ehughes/FPGA_SHIELD_MARK1/SCH/MARK1/REV A/Mechanical_Notes.txt

**** Mechanical Notes **********************************************************

*** PCB Fabrication ***
       - Will intially design to meet fabrication spec of advanced cicruits $66 4 layer special.
         This will allow for cheapest prototyping and end manufacturing costs
              - trace/widtch = 6/6mils , minimum thru = 15mil
              - min annular ring: vias=10mil , component holes=15mils
              - see link for further info: http://www.4pcb.com/index.php?load=content&page_id=131

*** Board Size ***
    - Would like to minimize size while keeping wanted features.
    - Would like to keep size relatively close to other arduino shields for compatibility of
    existing enclosured, etc.
    - standard size of existing arduino shields?

*** PMOD mechanical requirements ***
   - Need to find out if I can get the design standards from digilent on the mechanical
   characteristics of PMODS.
   - On my nexys3 board the 4 onboard pmods are spaced .400" hole to hole from each pmod

*** Arduino ***
    - Not sure what mechanical specs are required?
    - would love to get rid of the mounting holes  on the arduino header if possible

*** Footprints ***
    - Modified the usb back side thru holes so that data lines can escape from the back side
      - need to check to make sure that the part fits ok and does not conflict with the assembly process.
