ehughes/FPGA_SHIELD_MARK1/SCH/MARK1/REV A/Revision_Notes.txt

**** Revision_Notes *****

*** RA.1

    ERRATA:
      -  R18 needs tomb stoned a pulled to +3.3v (mj fixed)
      - PB6 needs attached to GND, not 3v3  (mj fixed)
