ehughes/FPGA_SHIELD_MARK1/SCH/MARK1/REV A/BUILD_PACKAGE/BOM/Assembly BOM - PMODS-FPGA_SHIELD_MARK1(PMODS).xls

Sheet: Part List Report
 | Assembly Sheet |  |  | Assembly BOM - PMODS For Variant [PMODS] of Project [FPGA_SHIELD_MARK1.PrjPcb] (No PCB Document Selected)
 |  |  | Variant: | PMODS
 | Report Date: |  | 6/7/2012 | 7:56:00 PM
 | Print Date: |  | 2012-06-07 | 19:56:41
# | Quantity | Designator | Description | Manufacturer | Manufacturer Part Number | Supplier 1 | Supplier Part Number 1
1 | 17 | C1, C2, C3, C4, C7, C8, C11, C29, C32, C33, C37, C41, C43, C44, C45, C46, C47 | CAP CER .1UF 50V 10% X7R 0603 | Murata Electronics North America | GRM188R71H104KA93D | Digi-Key | 490-1519-1-ND
2 | 16 | C5, C6, C12, C13, C15, C16, C21, C22, C24, C26, C28, C30, C31, C34, C36, C38 | CAP CER 4.7UF 6.3V X5R 0603 | Murata Electronics North America | GRM188R60J475KE19D | Digi-Key | 490-3297-1-ND
3 | 2 | C9, C10 | CAP CER 18PF 50V 5% C0G 0603 | Murata Electronics North America | GRM1885C1H180JA01D | Digi-Key | 490-1409-1-ND
4 | 12 | C14, C17, C18, C19, C20, C23, C25, C27, C35, C39, C40, C42 | CAP CER .47UF 25V X7R 0603 | Murata Electronics North America | GCM188R71E474KA64D | Digi-Key | 490-4776-1-ND
5 | 4 | D1, D2, D4, D5 | DIODE SCHOTTKY 25V 1A SOD123 | Diodes Inc | Rohm Semiconductor | Digi-Key | RB161M-20CT-ND
6 | 19 | D3, D7, DC1, DC2, DC3, DC4, DC5, DC6, DC7, DC8, DC9, DC10, DC11, DC12, DC13, DC14, DC15, DC16, DC17 | LED 1.6X0.8MM 570NM GRN CLR SMD | Kingbright Corp | APT1608CGCK | Digi-Key | 754-1116-2-ND
7 | 2 | J1, J3 | CONN RCPT STD MICRO USB TYPE B | FCI | 10103594-0001LF | Digi-Key | 609-4050-1-ND
8 | 1 | J4 | CONN FEMALE 16POS DL .1" R/A TIN | Sullins | PPTC082LJBN-RC | Digikey | S5522-ND
9 | 5 | J7, J8, J9, J12, J13 | CONN FEMALE 12POS DL .1" R/A TIN | Sullins | PPTC062LJBN-RC | Digikey | S5520-ND
10 | 6 | PB0, PB1, PB2, PB3, PB5, PB6 | SWITCH TACTILE SPST-NO 0.05A 12V | TE Connectivity | FSM4JSMATR | Digi-Key | 450-1759-2-ND
11 | 1 | Q1 | MOSFET P-CH 30V 900MA SSOT3 | Fairchild Semiconductor | NDS352AP | Digi-Key | NDS352APCT-ND
12 | 4 | R1, R4, R5, R6 | RES 33.0 OHM 1/10W 1% 0603 SMD | Panasonic - ECG | ERJ-3EKF33R0V | Digi-Key | P33.0HCT-ND
13 | 24 | R2, R3, R8, R10, R11, R12, R13, R14, R15, R16, R17, R18, R28, R29, R30, R31, R32, R33, R34, R35, R38, R40, R41, R43 | RES 10.0K OHM 1/10W 1% 0603 SMD | Panasonic - ECG | ERJ-3EKF1002V | Digi-Key | P10.0KHCT-ND
14 | 1 | R7 | RES 1.50K OHM 1/10W 1% 0603 SMD | Panasonic - ECG | ERJ-3EKF1501V | Digi-Key | P1.50KHCT-ND
15 | 16 | R9, R19, R20, R21, R22, R23, R24, R25, R26, R27, R37, R39, R42, R44, R45, R46 | RES 200 OHM 1/10W 1% 0603 SMD | Panasonic - ECG | ERJ-3EKF2000V | Digi-Key | P200HCT-ND
16 | 1 | R36 | RES ZERO OHM 1/10W 5% 0603 SMD | Panasonic - ECG | ERJ-3GEY0R00V | Digi-Key | P0.0GCT-ND
17 | 1 | SW1 | SWITCH DIP SPST EXT ACT 8POS SMD | TE Connectivity | ADE08S04 | Digi-Key | 1-1825058-9-ND
18 | 1 | T1 | PC TEST POINT COMPACT SMT | Keystone Electronics | 5016 | Digi-Key | 5016KCT-ND
19 | 1 | U1 | IC USB SERIAL BASIC UART QFN-16 | FTDI, Future Technology Devices International Ltd | FT230XQ-R | Digi-Key
20 | 1 | U2 | IC REG LDO 3.3V 950MA SOT-223 | STMicroelectronics | LD1117S33CTR | Digi-Key | 497-1241-1-ND
21 | 1 | U3 | IC FLASH 16MBIT 75MHZ 8SOIC | Numonyx/ST Micro | M25PE16-VMW6TG | Digi-Key | M25PE16-VMW6TGCT-ND
22 | 1 | U4 | IC LDO REG 1A 1.2V SOT223-3 | Microchip Technology | MCP1826S-1202E/DB | Digi-Key | MCP1826S-1202E/DB-ND
23 | 1 | U5 | IC MCU 32BIT 32KB FLASH 48LQFP | NXP Semiconductors | LPC1343FBD48,151 | Digi-Key | 568-4945-ND
24 | 1 | U6 | CRYSTAL 12.000MHZ 18PF SMD | Abracon Corporation | ABM3-12.000MHZ-B2-T | Digi-Key | 535-9100-1-ND
25 | 2 | U7, U9 | IC 8-BIT TRNSTR 15KV ESD 20TSSOP | Texas Instruments | TXB0108PWR | Digi-Key | 296-21527-1-ND
26 | 1 | U8 | IC FPAG SPARTAN 6 9K 144TQFP | Xilinx Inc | XC6SLX9-3TQG144C | Digi-Key | 122-1747-ND
27 | 1 | U10 | OSC MEMS 50.000 MHZ SMD | Abracon Corporation | ASDMB-50.000MHZ-LC-T | Digi-Key | 535-11738-1-ND
Approved |  |  |  | Notes

Sheet: Project Information
Project Full Path | C:\eli\BUSINESS\CLIENT_DATA\WAVENUMBER\FPGA_SHIELD_MARK_1\SCH\MARK1\FPGA_SHIELD_MARK1.PrjPcb
Project Filename | FPGA_SHIELD_MARK1.PrjPcb
Variant Name | PMODS
Data-Source Filename | FPGA_SHIELD_MARK1.PrjPcb
Data-Source Full Path | C:\eli\BUSINESS\CLIENT_DATA\WAVENUMBER\FPGA_SHIELD_MARK_1\SCH\MARK1\FPGA_SHIELD_MARK1.PrjPcb
Title | Assembly BOM - PMODS For Variant [PMODS] of Project [FPGA_SHIELD_MARK1.PrjPcb] (No PCB Document Selected)
Total Quantity | 143
Report Time | 7:56:00 PM
Report Date | 6/7/2012
Report Date & Tine | 6/7/2012 7:56:00 PM
Output Name | Assembly BOM - PMODS
Output Type | BOM_PartType
Output Generator Name | BOM
Output Generator Description | Bill of Materials
