ehughes/FPGA_SHIELD_MARK1/SCH/MARK1/REV A/BUILD_PACKAGE/SCHEMATICS/SCH-FPGA_MARK1.pdf

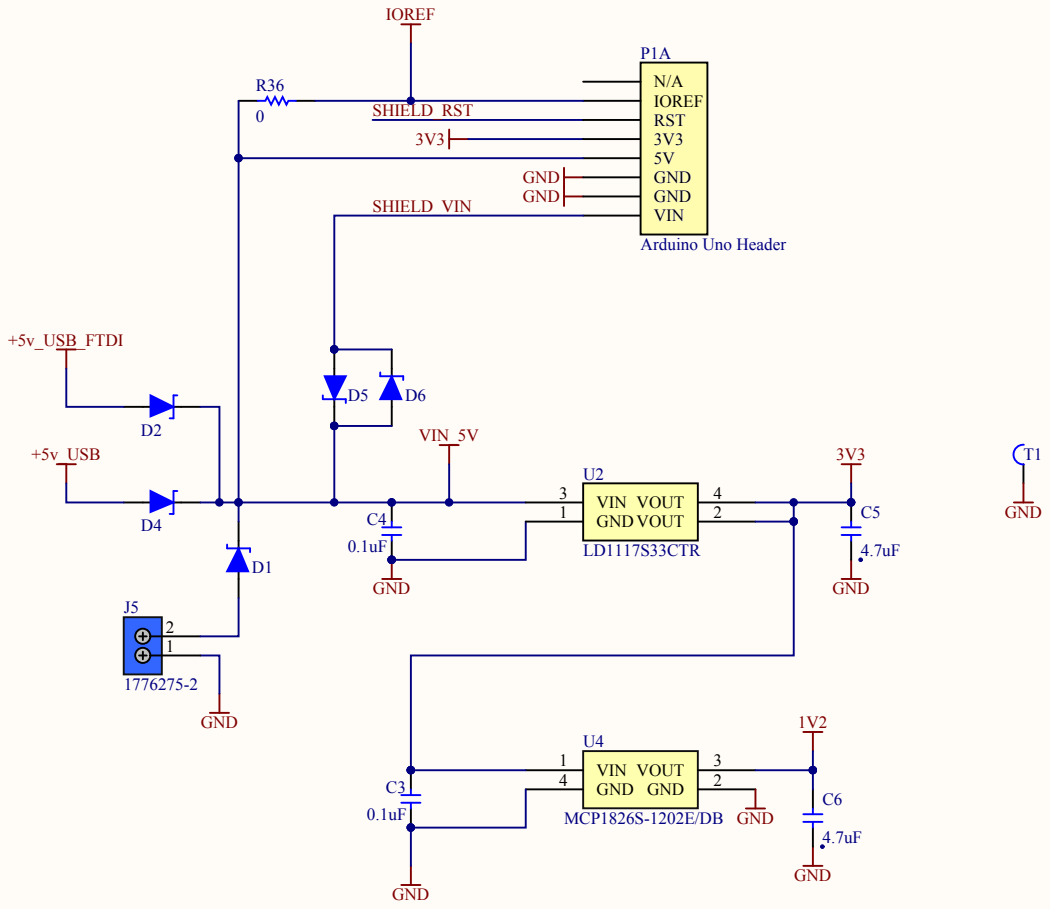
[picture p1: page 1]

Power Supply

α Rev: | FPGA MARK-1

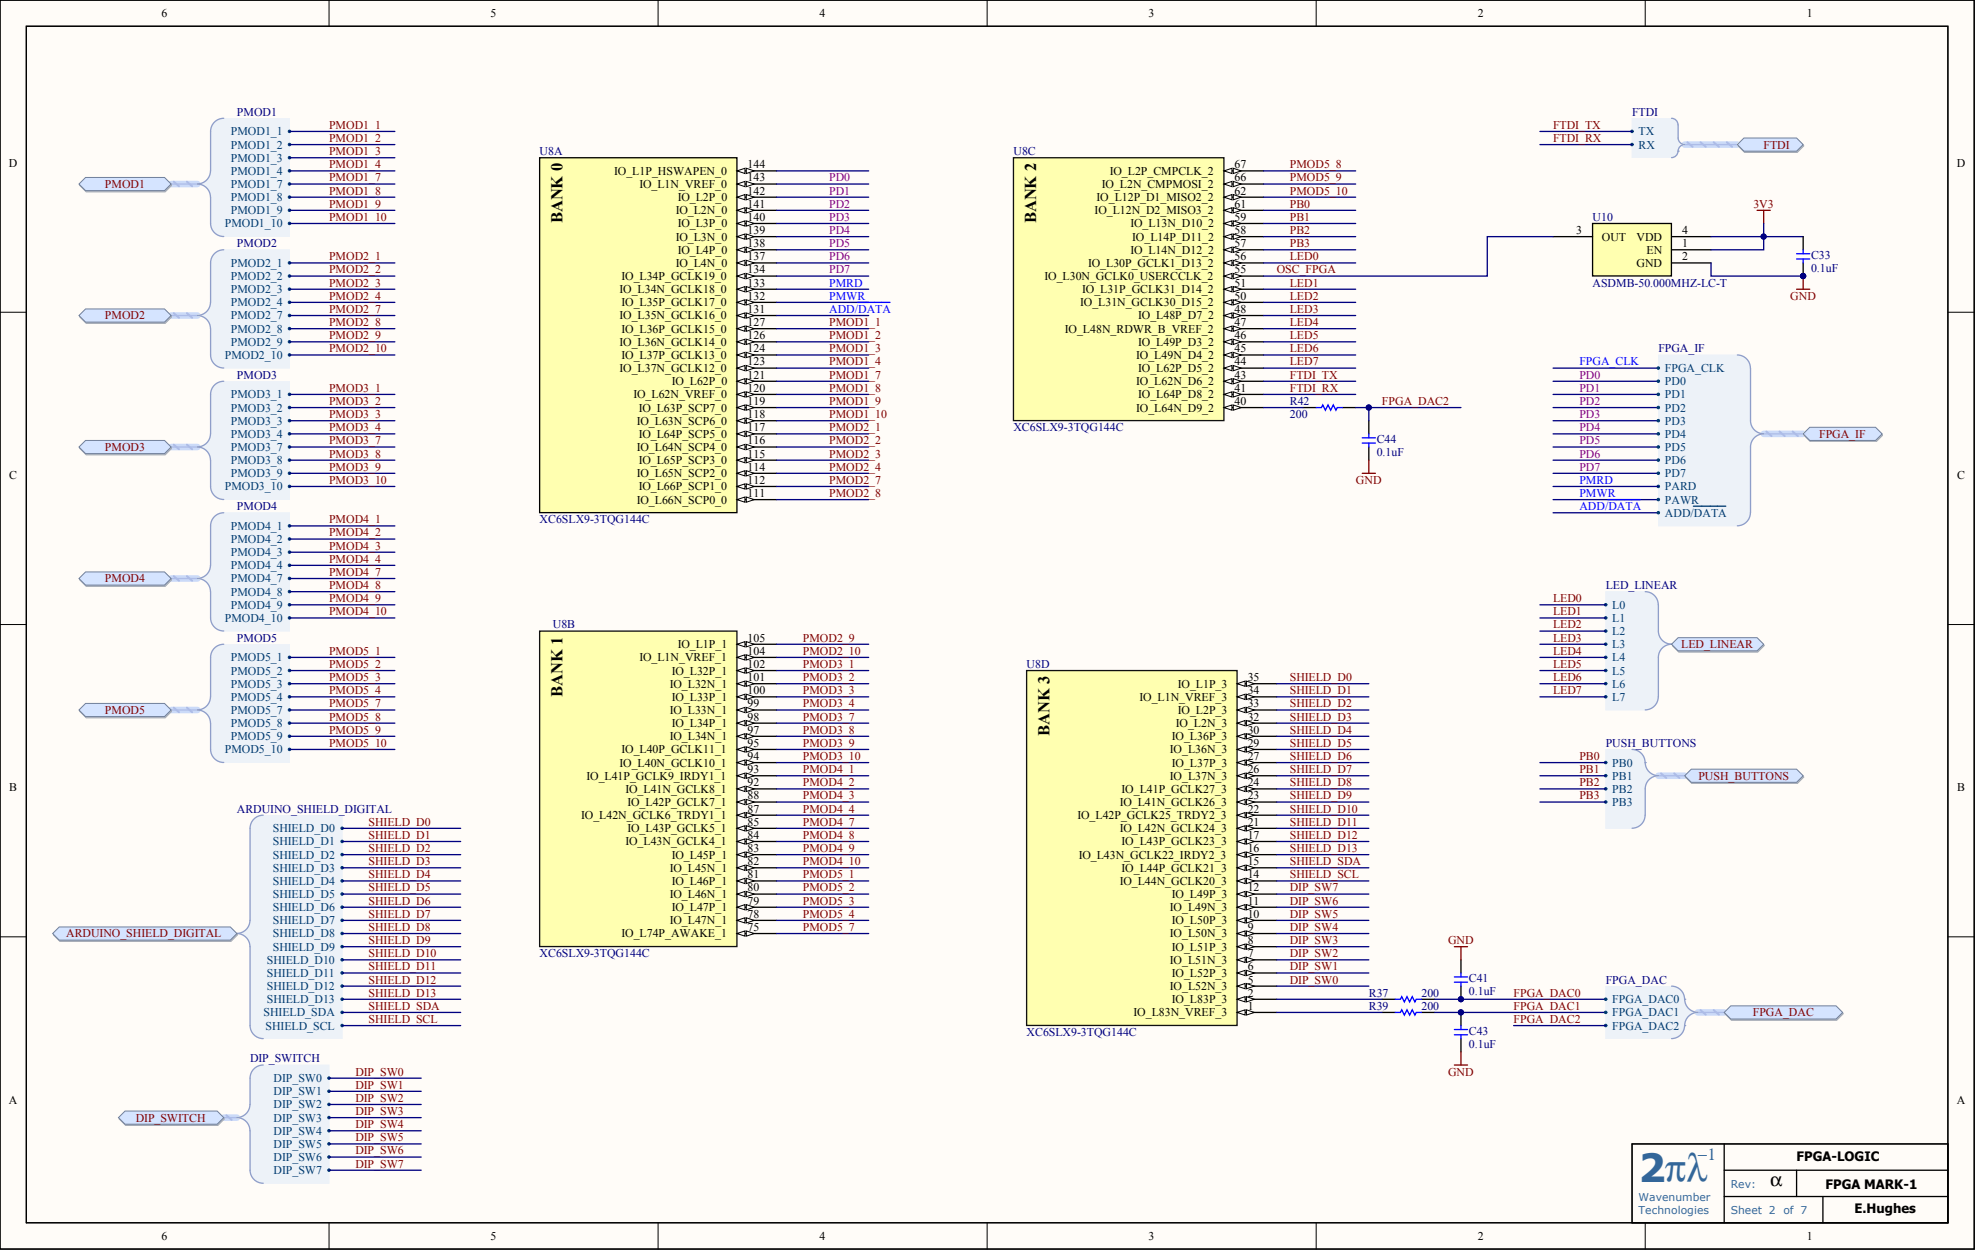
[picture p2: page 2]

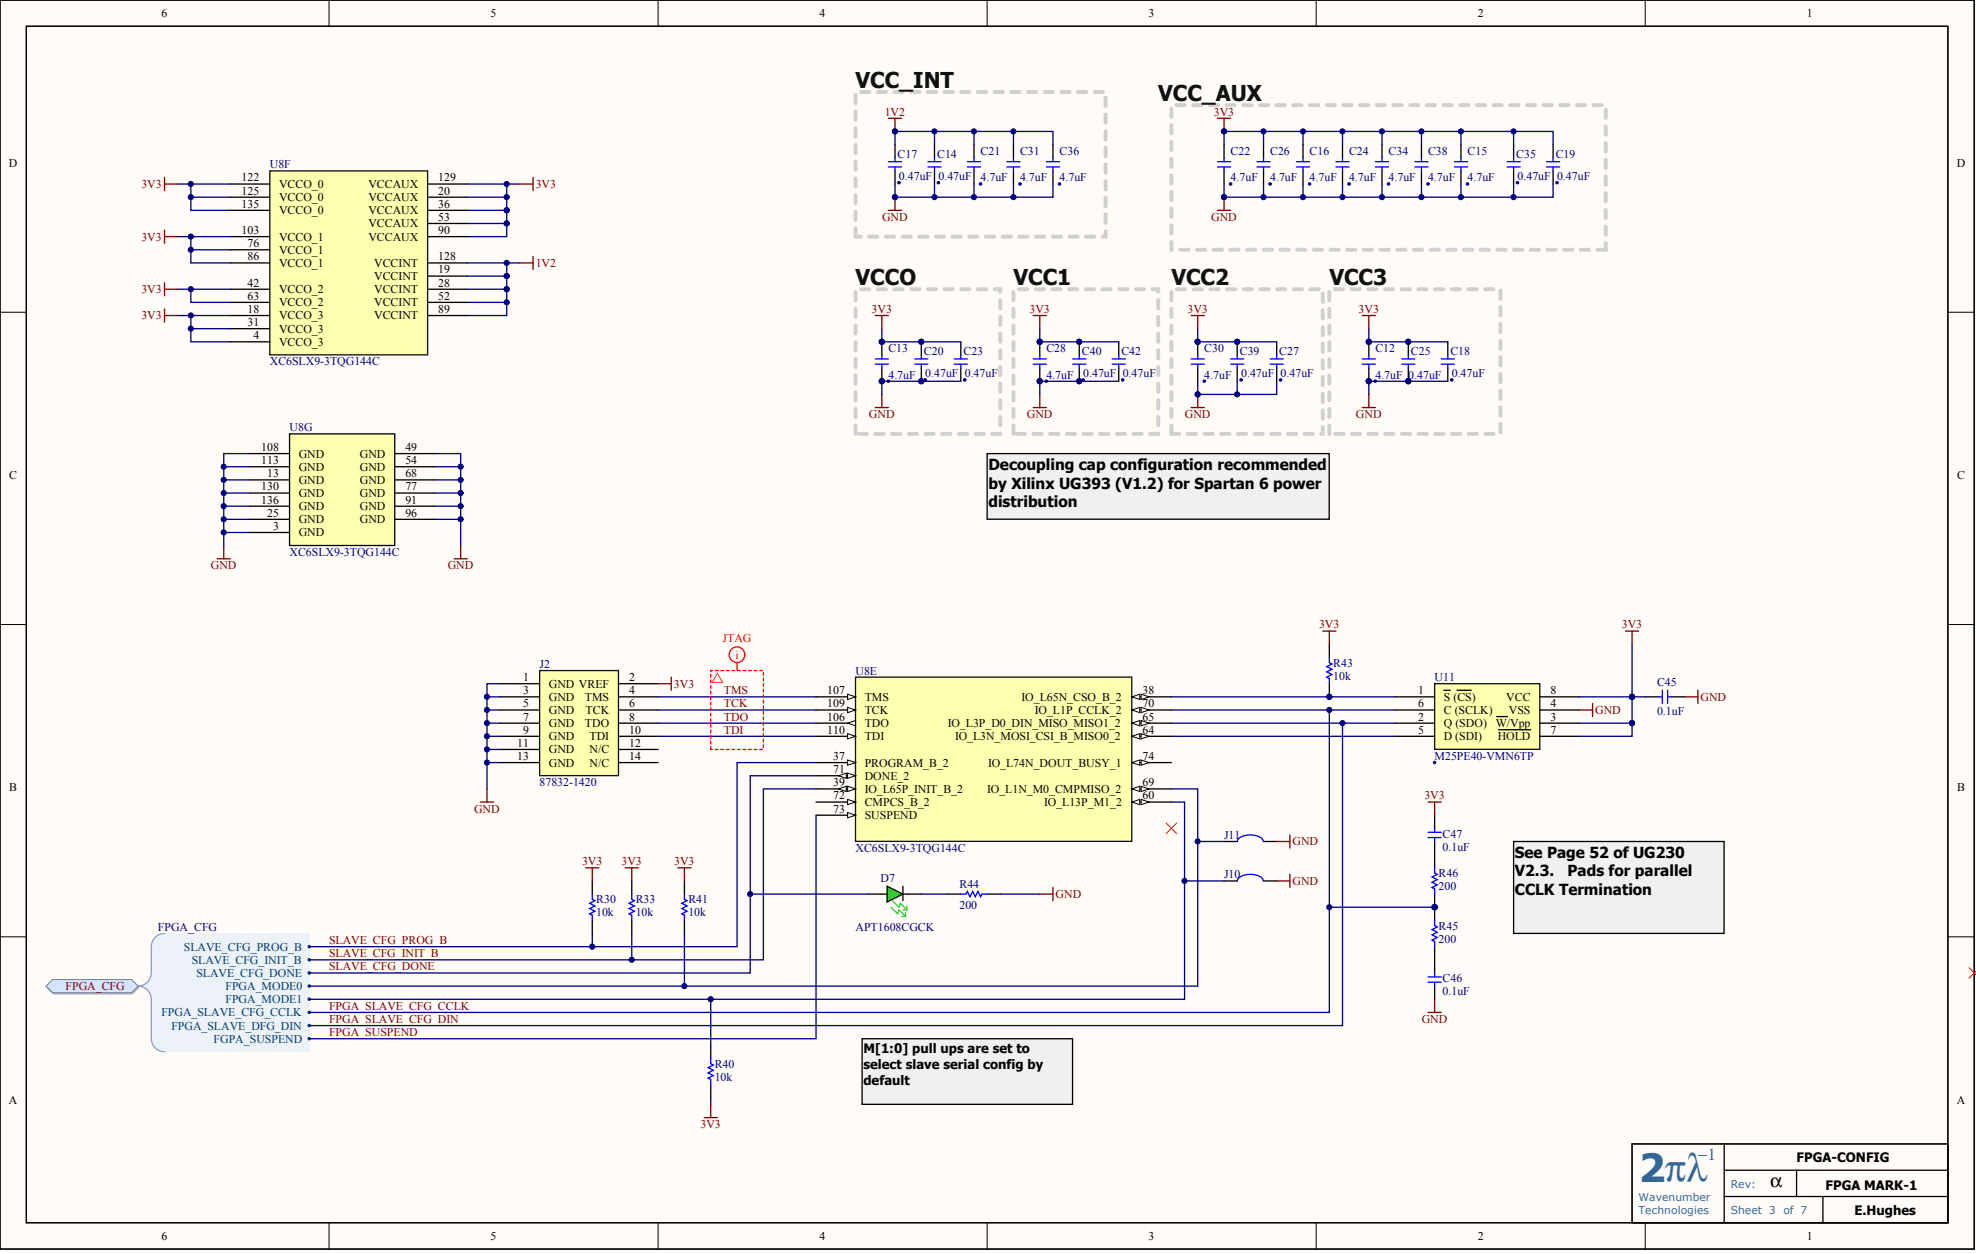
[picture p3: page 3]

Decoupling cap configuration recommended
by Xilinx UG393 (V1.2) for Spartan 6 power
distribution

GND 9 TDI N/C | 10 | TDI | TDI 110 IO_L3N_MOSI_CSI_B_MISO0_2 IO_L74N_DOUT_BUSY_1 IO_L1N_M0_CMPMISO_2 | 64 | D (SDI) 5

GND 13 | 14

PROGRAM_B_2 37 | 74
DONE_2 71 | 69

87832-1420 | | IO_L65P_INIT_B_2 39

CMPCS_B_2 72

GND | | SUSPEND 73

SLAVE_CFG_INIT_B
SLAVE_CFG_DONE

FPGA_SLAVE_CFG_CCLK
FPGA_SLAVE_CFG_DIN
FPGA_SUSPEND

M[1:0] pull ups are set to
select slave serial config by
default

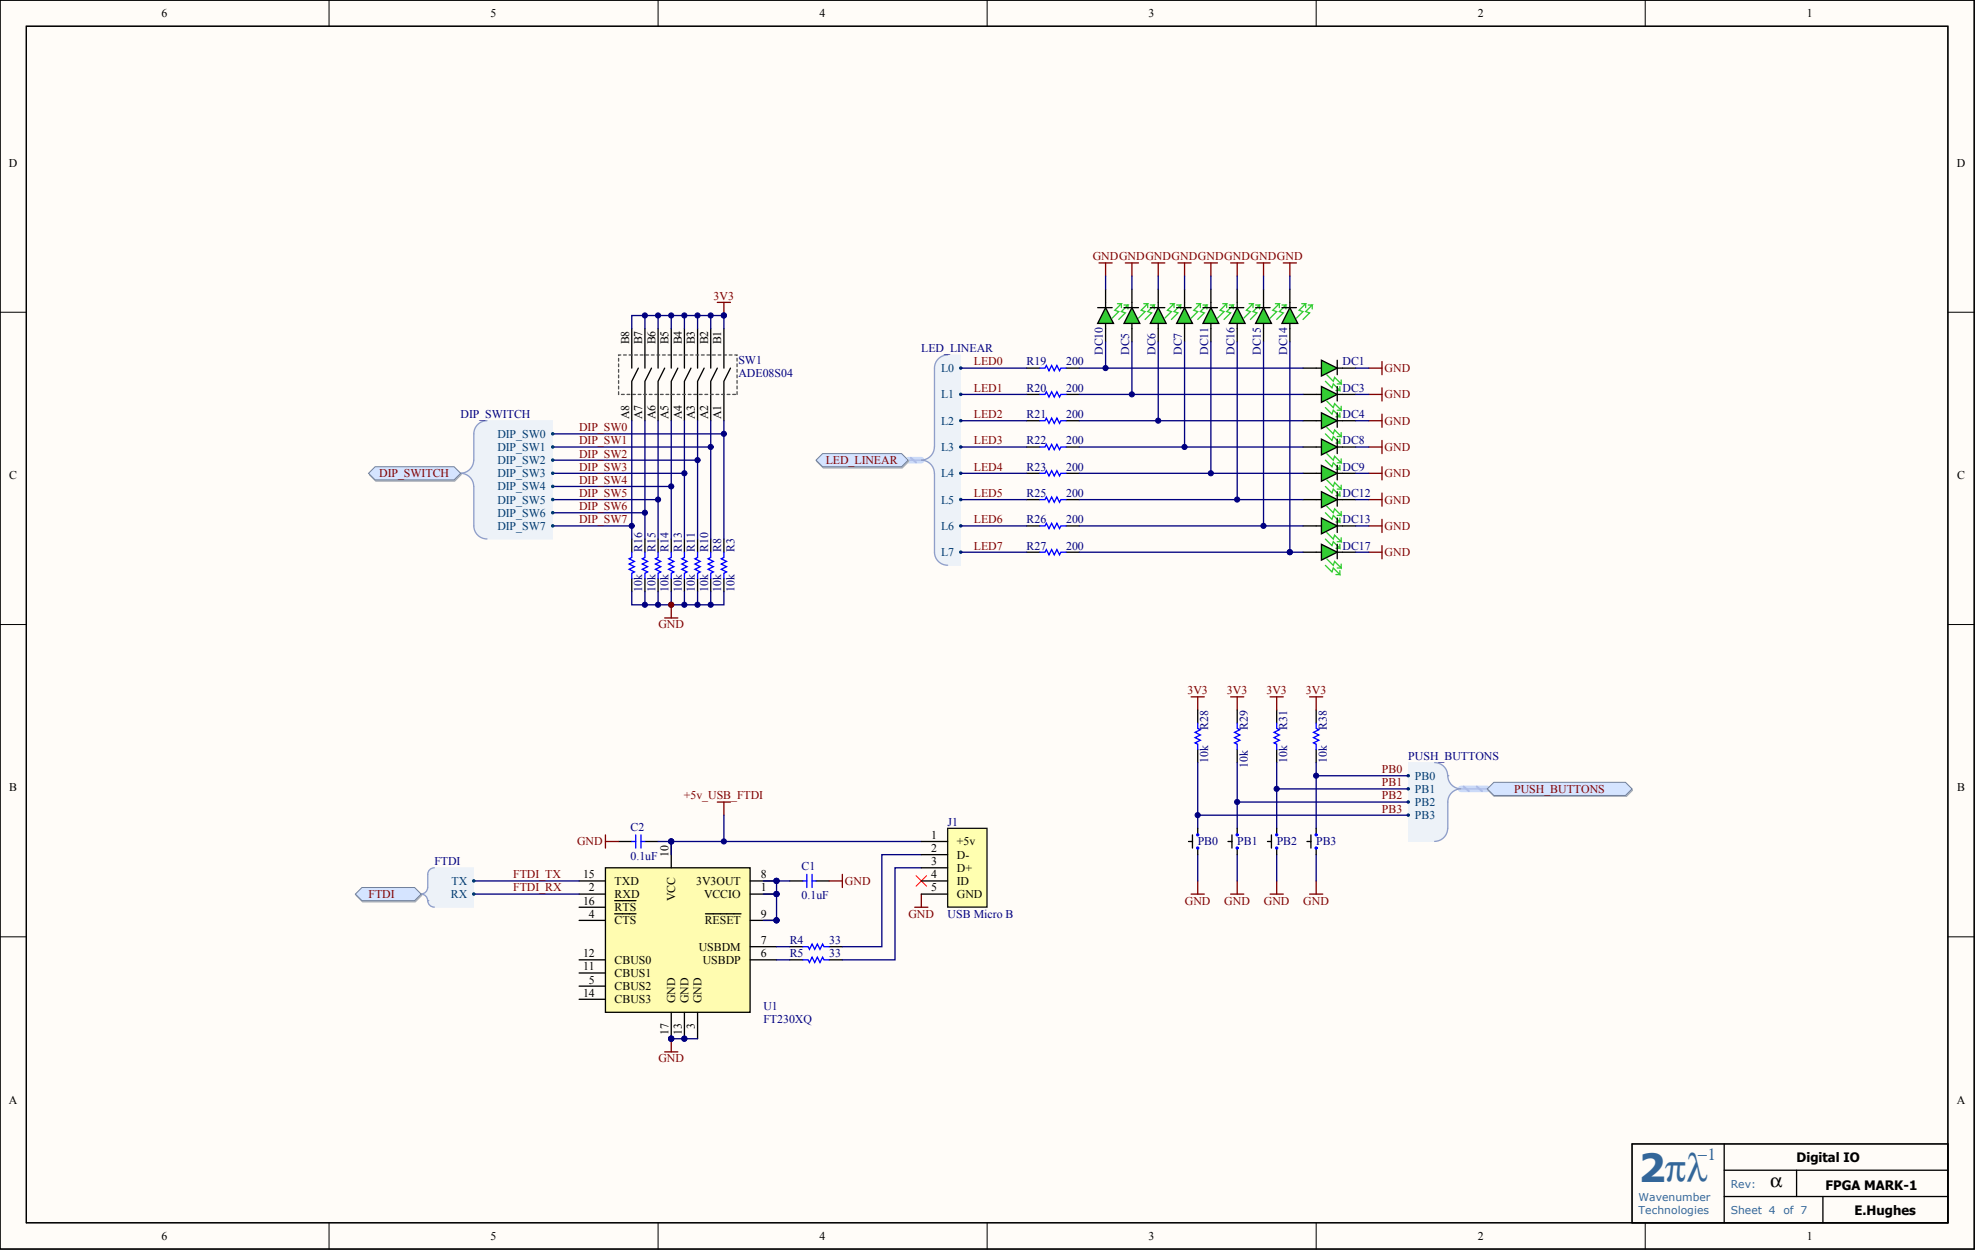
[picture p4: page 4]

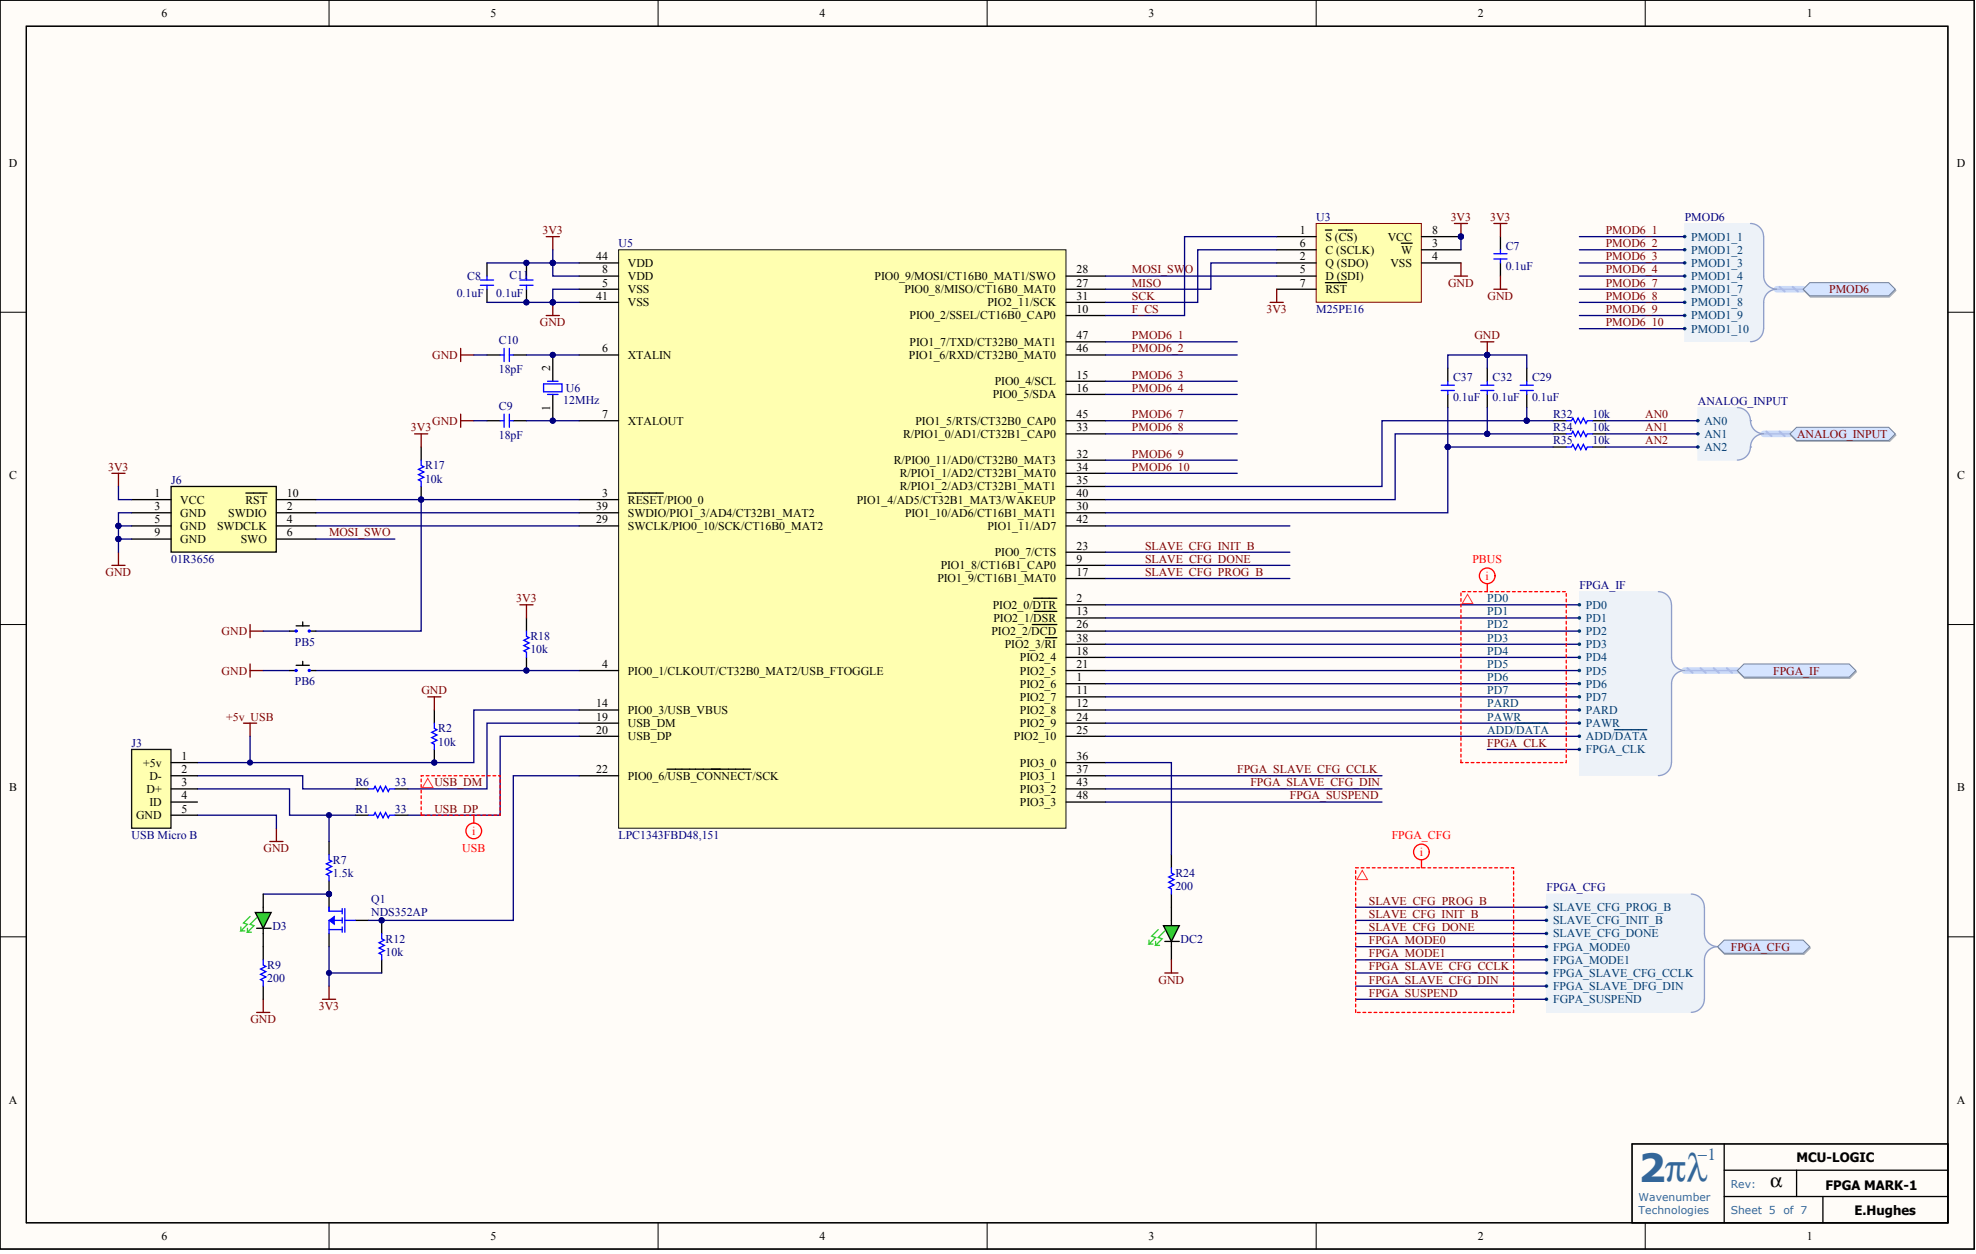
[picture p5: page 5]

MISO | 7

VSS 41 | | SCK F_CS

9 | | PIO0_3/USB_VBUS 14

USB_DM 19

R2 | USB_DP 20
10k | PIO0_6/USB_CONNECT/SCK 22

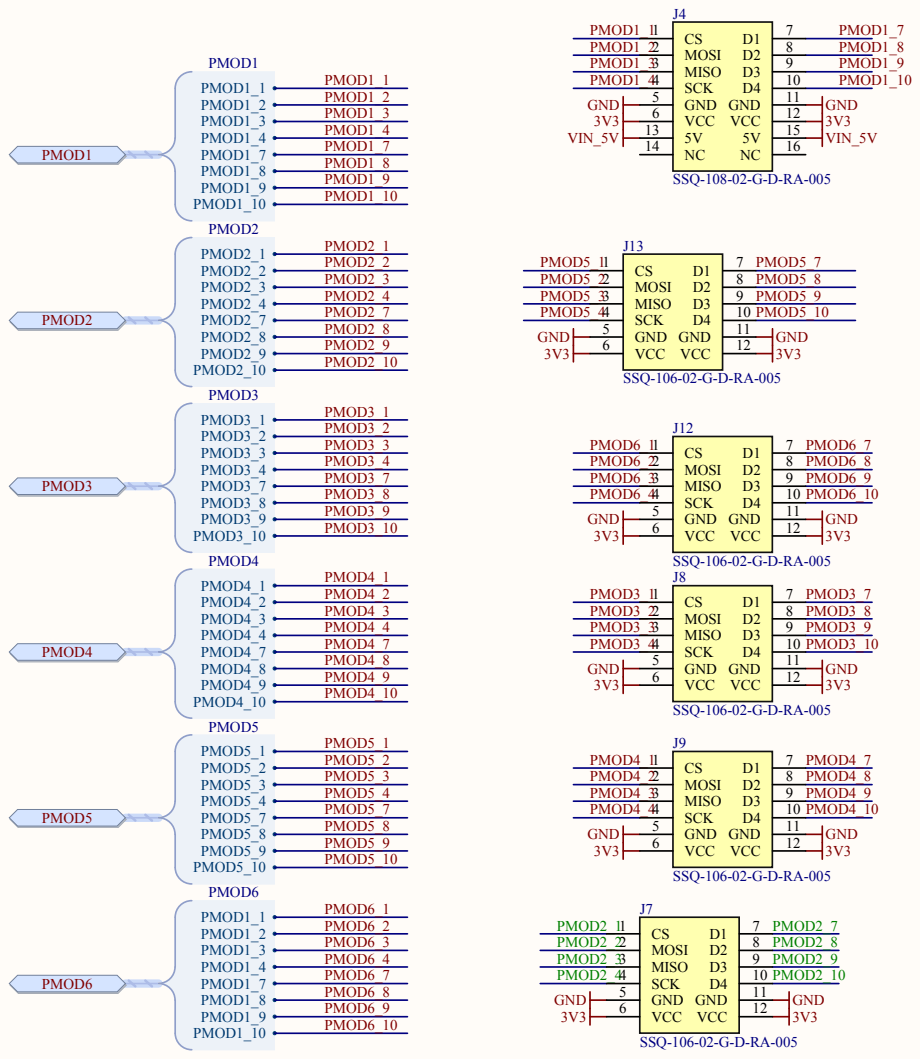
[picture p6: page 6]

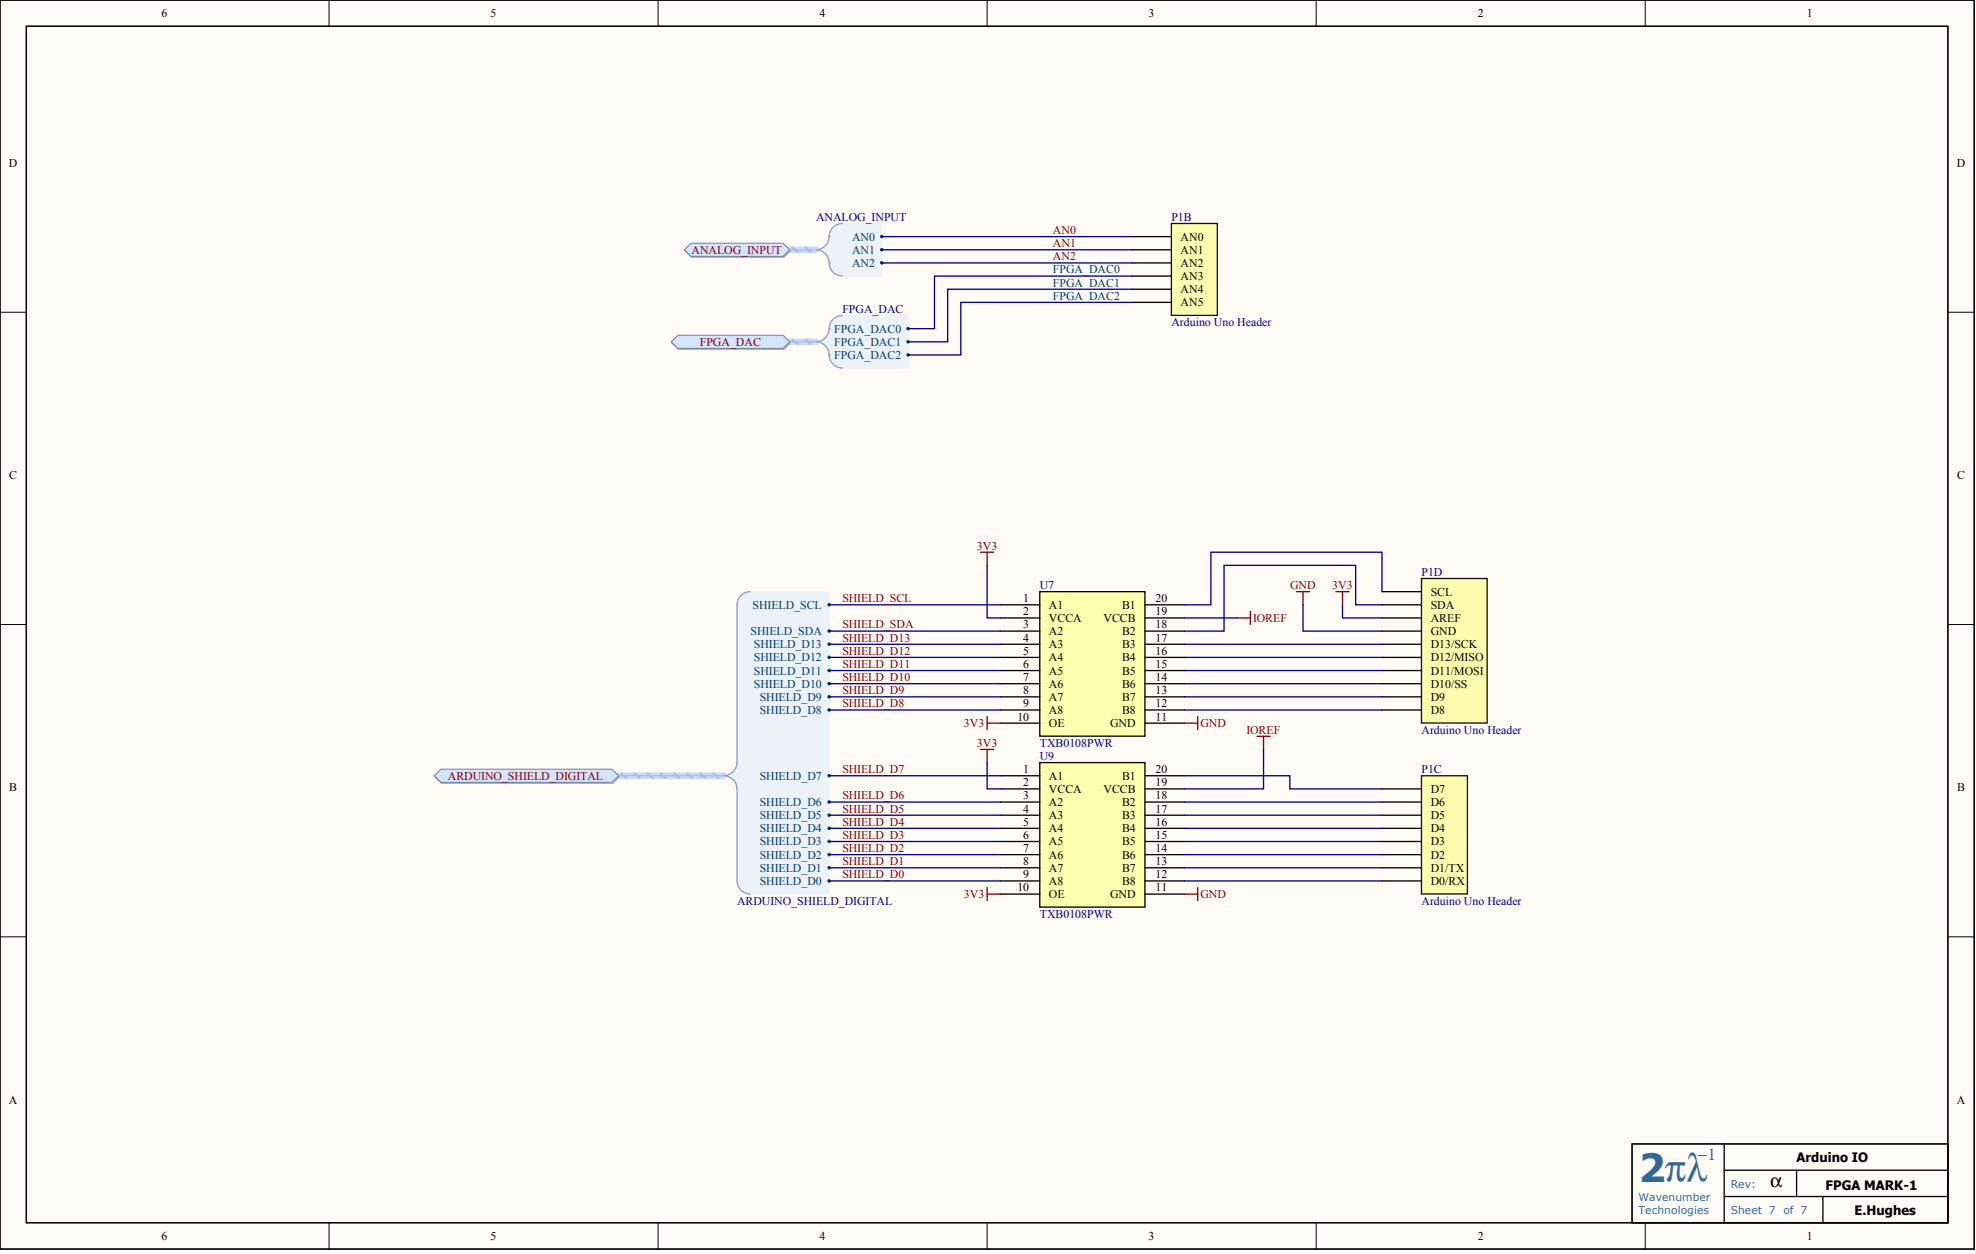
[picture p7: page 7]

FPGA_DAC1
FPGA_DAC2

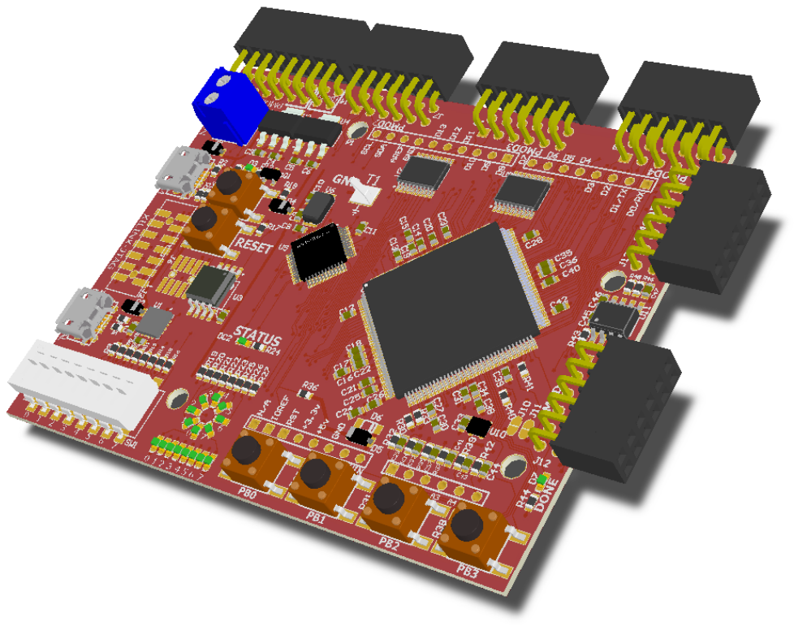
[picture p8: page 8]

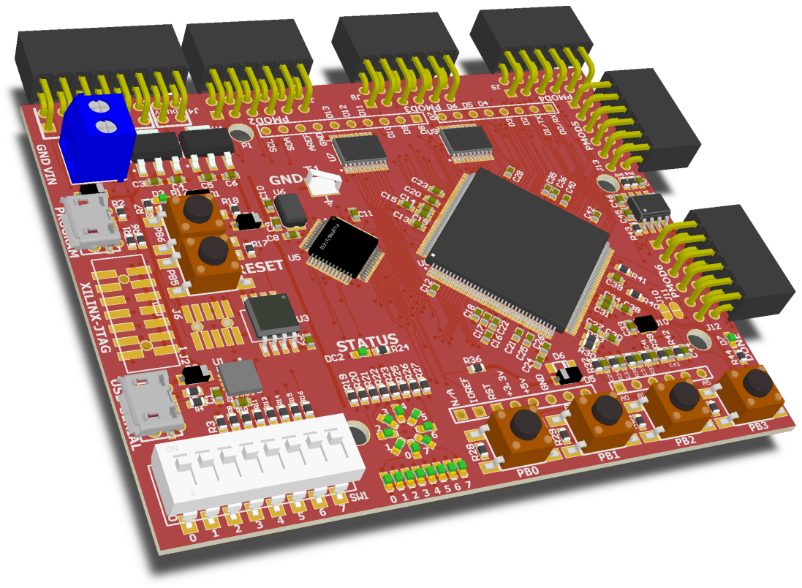
[picture p9: page 9]
