ehughes/FPGA_SHIELD_MARK1/SCH/MARK1/REV A/BUILD_PACKAGE/PCB_NOTES-FPGA_MARK1.pdf

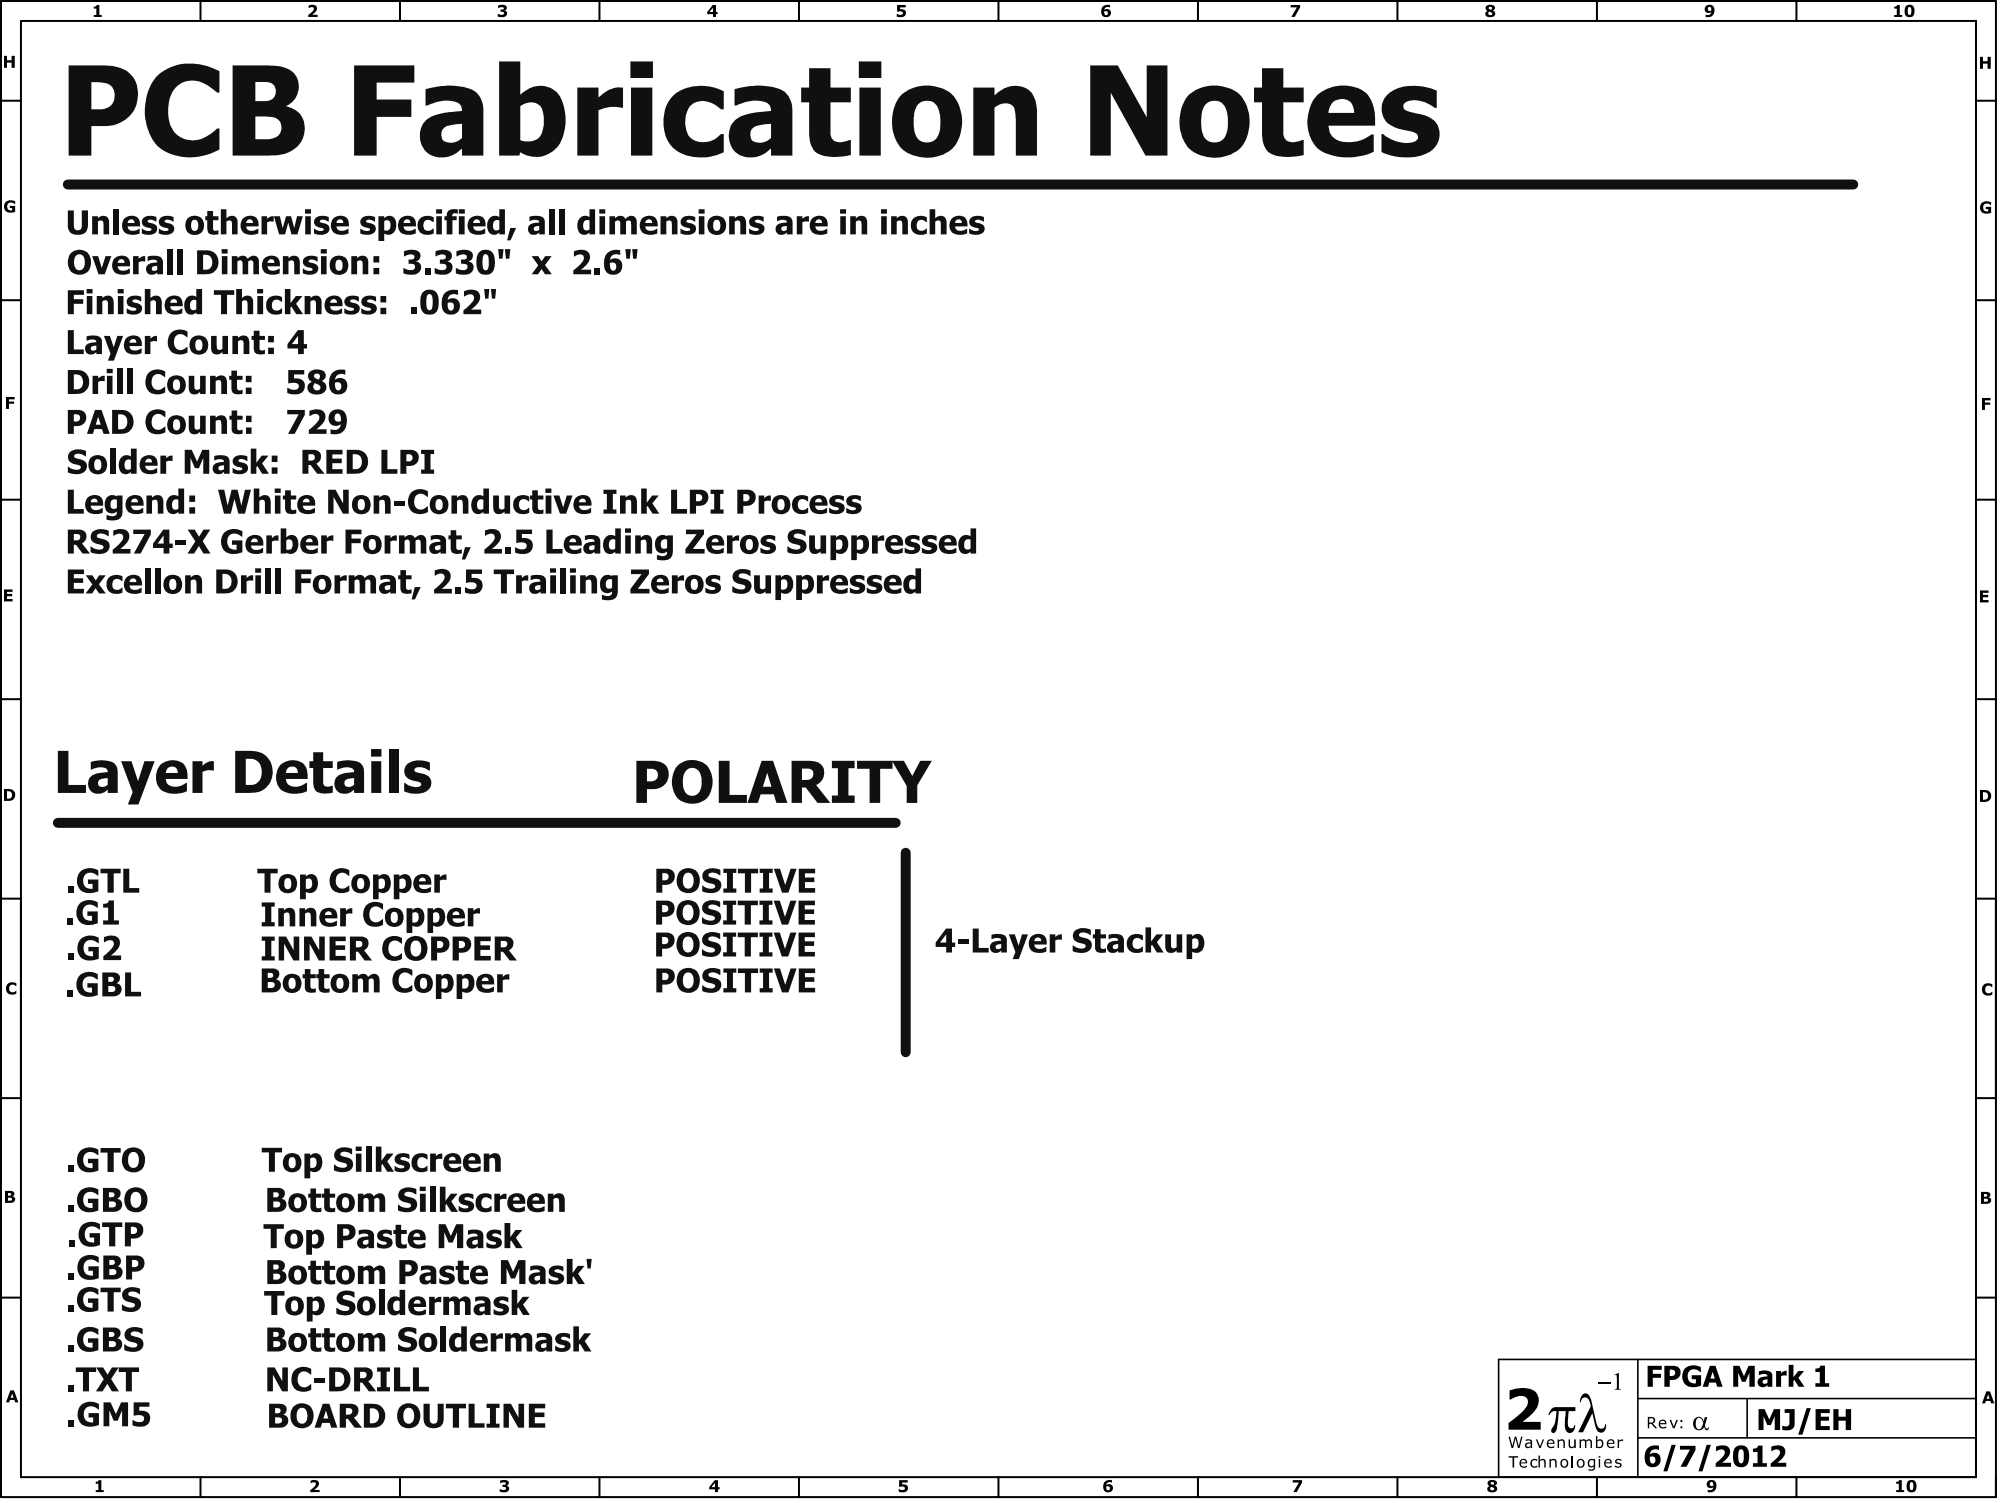
[picture p10: page 1]

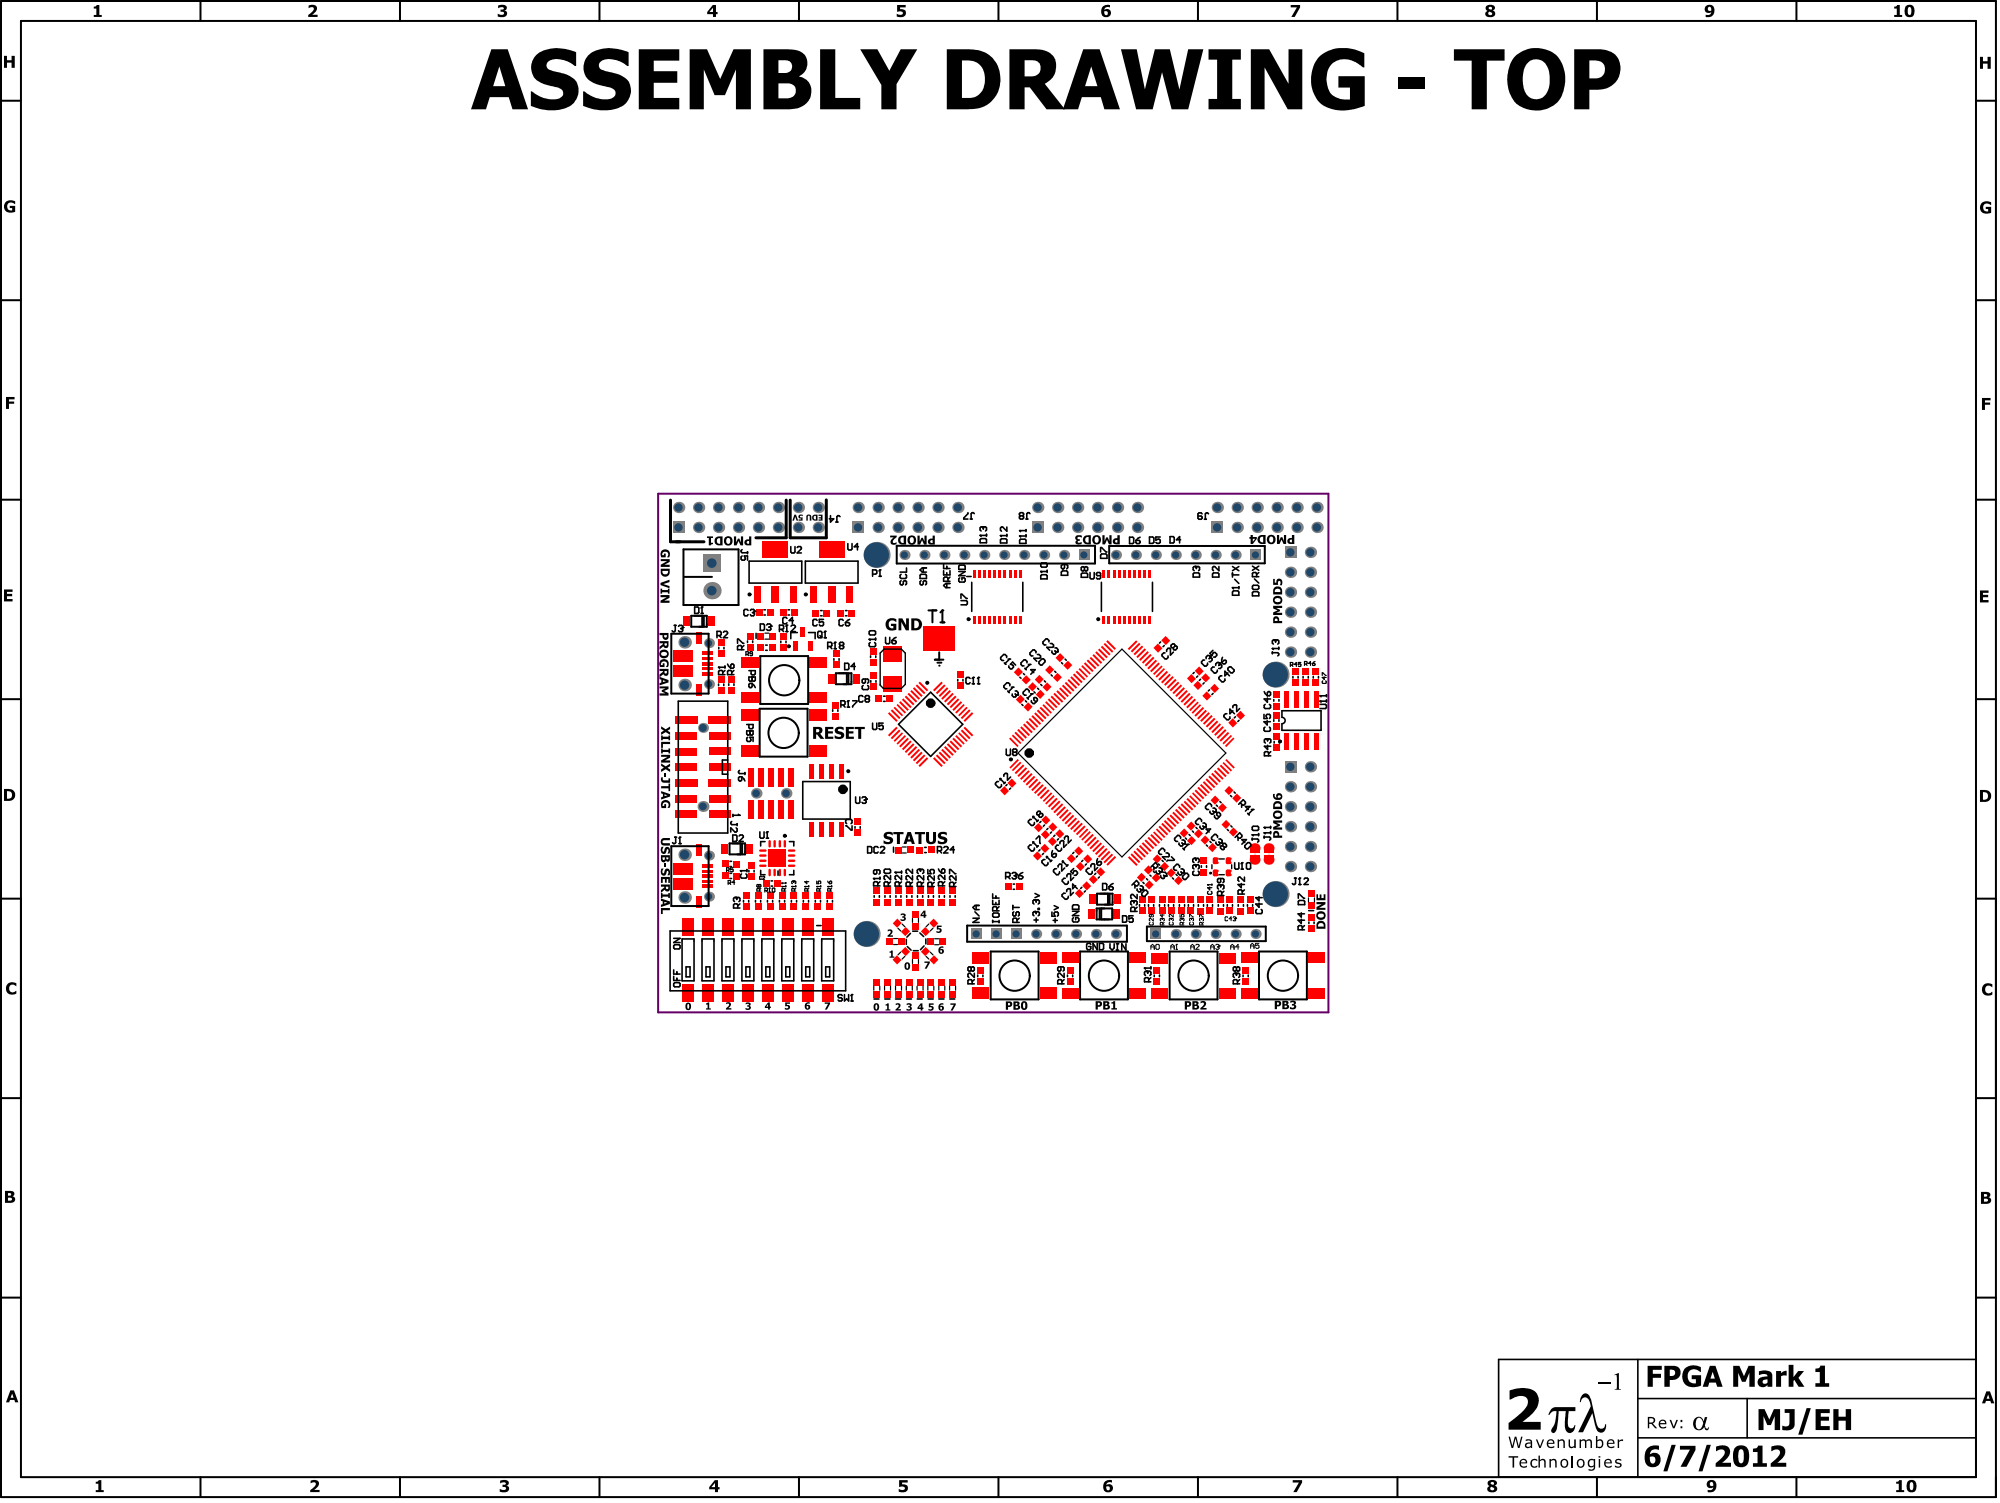
[picture p11: page 2]

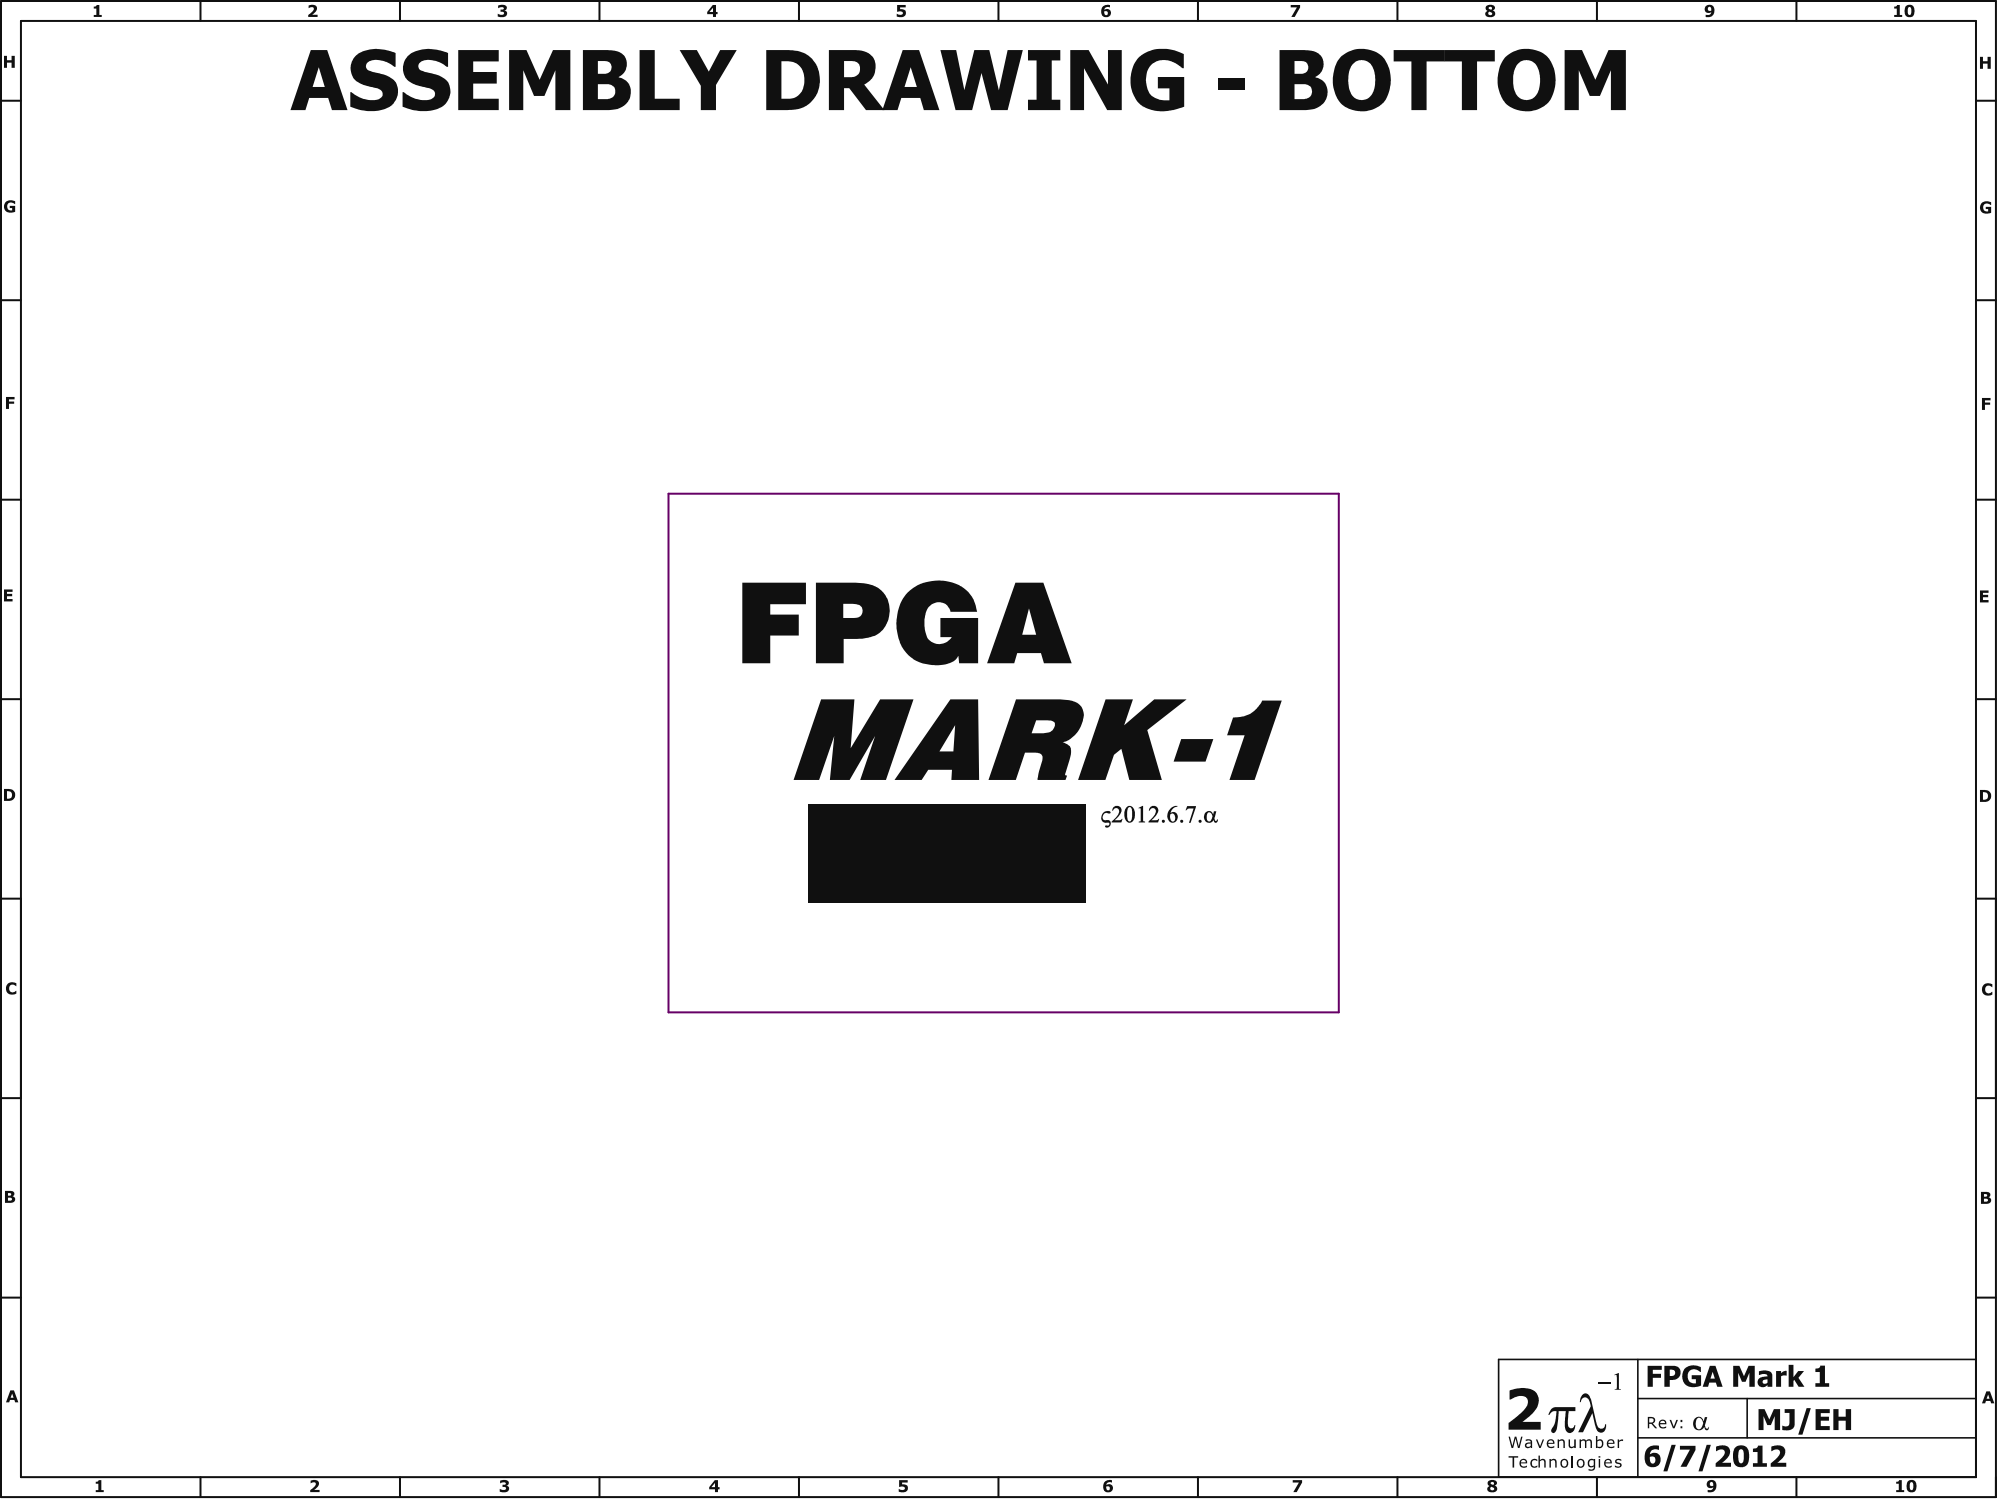
[picture p12: page 3]

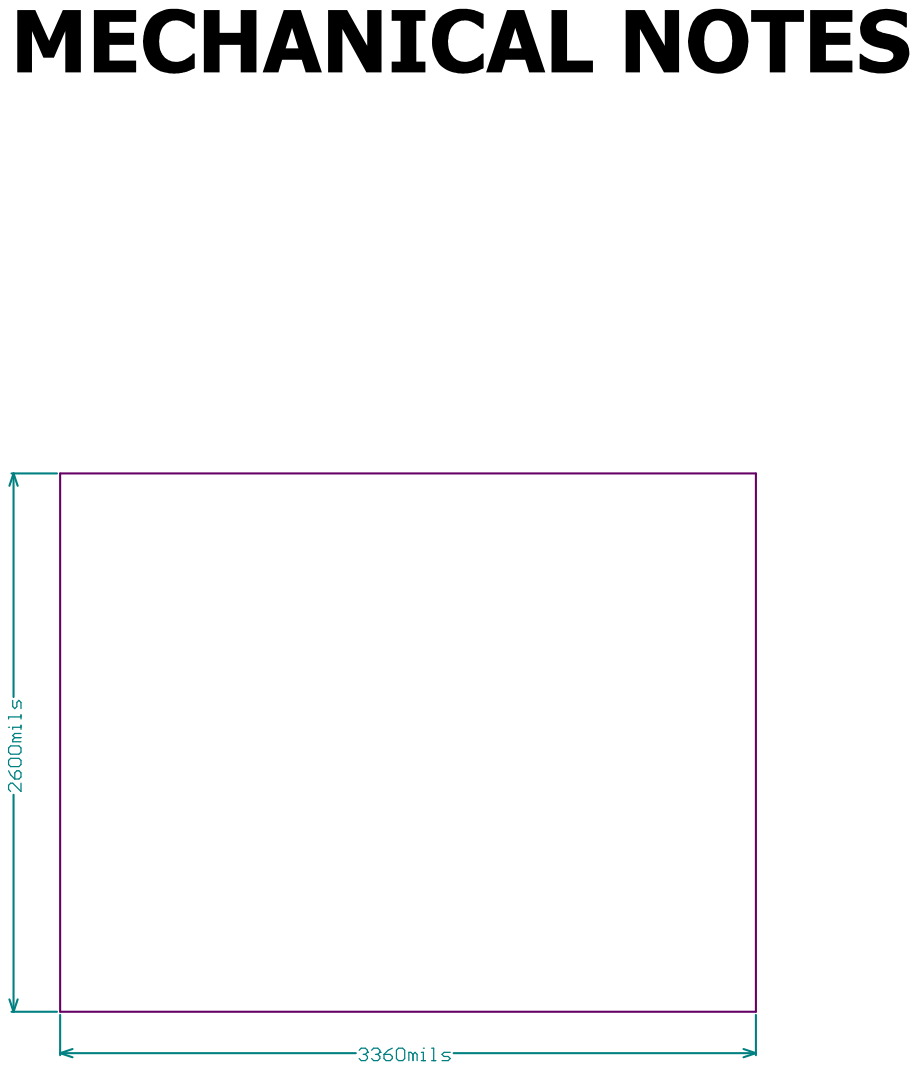
[picture p13: page 4]
