ehughes/FPGA_SHIELD_MARK1/(list of files, drawings)

Other design files:
SCH/MARK1/DIGITAL_IO.SchDoc
SCH/MARK1/FPGA_SHIELD_MARK1.PrjPcb
SCH/MARK1/LOGIC_FPGA.SchDoc
SCH/MARK1/PMOD_IO.SchDoc
SCH/MARK1/REV A/ANALOG_IO.SchDoc
SCH/MARK1/REV A/ARDUINO_IO.SchDoc
SCH/MARK1/REV A/DIGITAL_IO.SchDoc
SCH/MARK1/REV A/EXTERNAL_IO.SchDoc
SCH/MARK1/REV A/FPGA_Logic.SchDoc
SCH/MARK1/REV A/FPGA_MCU_Control_Top.SchDoc
SCH/MARK1/REV A/FPGA_POWER_AND_CONFIGURATION.SchDoc
SCH/MARK1/REV A/FPGA_SHIELD_MARK1.PrjPcb
SCH/MARK1/REV A/FPGA_SHIELD_MARK1.SCHLIB
SCH/MARK1/REV A/LOGIC_FPGA.SchDoc
SCH/MARK1/REV A/LOGIC_MCU.SchDoc
SCH/MARK1/REV A/PMOD_IO.SchDoc
SCH/MARK1/REV A/POWER_SUPPLY.SchDoc
SCH/MARK1/REV A/PWR_Config.SchDoc
SCH/MARK1_AUDIO_PMOD/MARK1_AUDIO_PMOD.PcbDoc
SCH/MARK1_AUDIO_PMOD/MARK1_AUDIO_PMOD.PrjPcb
SCH/MARK1_AUDIO_PMOD/MARK1_AUDIO_PMOD.SchDoc
SCH/MARK1_EDU_PMOD/MARK1_EDU_PMOD.PcbDoc
SCH/MARK1_EDU_PMOD/MARK1_EDU_PMOD.PrjPcb
SCH/MARK1_EDU_PMOD/MARK1_EDU_PMOD.SchDoc
