ehughes/FPGA_SHIELD_MARK1/(commit log)

2012-01-02 1st Add.... Work in progress.
    [ANALOG_IO.SchDoc, DIGITAL_IO.SchDoc, EXTERNAL_IO.SchDoc, FPGA_Logic.SchDoc, FPGA_MCU_Control_Top.SchDoc, FPGA_POWER_AND_CONFIGURATION.SchDoc, FPGA_SHIELD_MARK1.PrjPcb, LOGIC_FPGA.SchDoc]
2012-01-02 Work In progress commit....
    [ANALOG_IO.SchDoc, DIGITAL_IO.SchDoc, FPGA_POWER_AND_CONFIGURATION.SchDoc, FPGA_SHIELD_MARK1.PrjPcb, LOGIC_FPGA.SchDoc, LOGIC_MCU.SchDoc, POWER_SUPPLY.SchDoc]
2012-01-11 grouped components
    [LOGIC_MCU.SchDoc]
2012-01-17 Added Notes doc. Made tentative changes based on thoughts that are in the notes. Ideas maximize flexibility in use of a base board for multiple functions.. i.e master,slave, learn
    [DIGITAL_IO.SchDoc]
2012-01-17 Spaced pmods based on nexys3 board (.400"). Added mechanical notes doc that will drive placement and fab contraints of board.
    [FPGA_SHIELD_MARK1.PrjPcb]
2012-01-17 Added separate pmods for EDU, Audio PMODS. Masked those components on the base board.
    [ANALOG_IO.SchDoc, DIGITAL_IO.SchDoc]
2012-02-12 Added Spartan3A device (Part needs to modified to match the configuration topology of the S6 device.) Added an optional layout that contains some proto/learning elements.
    [FPGA_SHIELD_MARK1.PrjPcb]
2012-02-12 Placement option 1
    [DIGITAL_IO.SchDoc, FPGA_POWER_AND_CONFIGURATION.SchDoc, FPGA_SHIELD_MARK1.PrjPcb, LOGIC_FPGA.SchDoc, POWER_SUPPLY.SchDoc]
2012-02-16 Option 2 - Switches and LED options for layout. Maximum number of PMODs.
    [DIGITAL_IO.SchDoc, FPGA_SHIELD_MARK1.PrjPcb]
2012-03-08 Added S6 back to board
    [DIGITAL_IO.SchDoc, FPGA_POWER_AND_CONFIGURATION.SchDoc, FPGA_SHIELD_MARK1.PrjPcb, LOGIC_FPGA.SchDoc, POWER_SUPPLY.SchDoc]
2012-03-23 Added 4 PMODs and some more EDU components, VGA, DIP sw, etc.
    [MARK1_EDU_PMOD.PcbDoc, MARK1_EDU_PMOD.SchDoc]
2012-03-23 Added 4 PMODS on top side for possible connecto to EDU board. Buying all the extra pmods to use code from FPGA edu books would cost alot. It would be nice to put together a cheap EDU board that would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
    [DIGITAL_IO.SchDoc]
2012-03-23 updating PCB
    [MARK1_EDU_PMOD.PcbDoc]
2012-04-05 Made changes per visio top level block diagram. Added FTDI, pb, etc. Moved things around on the board based on ease of use for the EDU board and FPGA PB/SW/leds.
    [DIGITAL_IO.SchDoc, LOGIC_FPGA.SchDoc, LOGIC_MCU.SchDoc, POWER_SUPPLY.SchDoc]
2012-04-06 Added Te FSM4JSMA for Mike to check out.
    [DIGITAL_IO.SchDoc]
2012-04-06 Added EDU expandion 3d model
    [FPGA_SHIELD_MARK1.PrjPcb]
2012-04-06 Added correct headers, PS2 ports, added basic form factor for mating with the mark1.
    [MARK1_EDU_PMOD.PcbDoc, MARK1_EDU_PMOD.PrjPcb, MARK1_EDU_PMOD.SchDoc]
2012-04-07 Add SMT Buttons. Placed componets outside of border
    [DIGITAL_IO.SchDoc, FPGA_SHIELD_MARK1.PrjPcb, LOGIC_MCU.SchDoc]
2012-04-07 Moved input periphs to bottom of board. Free'd up mounting holes, Moved jtag programming out from underneath arduino stack. Buttons/SW/led free from arduino stack.
    [FPGA_SHIELD_MARK1.PrjPcb]
2012-04-07 Arduino shield model added. Added a DNP osc to fpga, in case of wanting to use the FPGA fully indpendnt from the MCU.
    [FPGA_POWER_AND_CONFIGURATION.SchDoc, LOGIC_FPGA.SchDoc]
2012-04-09 Added Single sided placement option.
    [DIGITAL_IO.SchDoc, FPGA_SHIELD_MARK1.PrjPcb, LOGIC_MCU.SchDoc]
2012-04-10 changed USB part (more robust). Near to final placing
    [DIGITAL_IO.SchDoc, FPGA_SHIELD_MARK1.PrjPcb, LOGIC_MCU.SchDoc]
2012-04-10 Periodic update
    [DIGITAL_IO.SchDoc, FPGA_POWER_AND_CONFIGURATION.SchDoc, LOGIC_FPGA.SchDoc, LOGIC_MCU.SchDoc]
2012-04-10 Got the Outjob Setup
    [Assembly BOM-FPGA_SHIELD_MARK1.xls, FPGA_SHIELD_MARK1.PrjPcb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]
2012-04-11 Began routing. Need to eliminate some IO. See layout notes.
    [DIGITAL_IO.SchDoc, FPGA_POWER_AND_CONFIGURATION.SchDoc, FPGA_SHIELD_MARK1.PrjPcb, LOGIC_FPGA.SchDoc, LOGIC_MCU.SchDoc, POWER_SUPPLY.SchDoc]
2012-04-12 Continued Routing. About there.
    [DIGITAL_IO.SchDoc, LOGIC_FPGA.SchDoc, LOGIC_MCU.SchDoc]
2012-04-12 Routed Mostly. See question in routing notes that need to be cleard up. Will clear up questions and fine tune routing.
    [POWER_SUPPLY.SchDoc]
2012-04-12 Work in progress. Added FPGA DAC lines
    [DIGITAL_IO.SchDoc, FPGA_POWER_AND_CONFIGURATION.SchDoc, FPGA_SHIELD_MARK1.PrjPcb, LOGIC_FPGA.SchDoc, LOGIC_MCU.SchDoc]
2012-04-13 Started Fixing up Silkscreen
2012-04-13 Made the mode pins static. There are really only 2 real possibilities. The default is SPI Flash mode. The slave config mode will always override (as well as JTAG).
    [DIGITAL_IO.SchDoc, FPGA_POWER_AND_CONFIGURATION.SchDoc, LOGIC_MCU.SchDoc]
2012-04-15 Added some more silkscreen labels
    [DIGITAL_IO.SchDoc]
2012-04-16 Fixed 2 different diodes footprints. Added silkscreen note for Reset on MCU. A silkscreen notes for the PMOD #'s
2012-04-16 Added power/gnd pours, cleaned up routing, ran DRC
    [DIGITAL_IO.SchDoc, FPGA_POWER_AND_CONFIGURATION.SchDoc, FPGA_SHIELD_MARK1.PrjPcb, LOGIC_FPGA.SchDoc, LOGIC_MCU.SchDoc, POWER_SUPPLY.SchDoc]
2012-04-16 Added 5V supply header for EDU board. Added plated to thru holes (required for advanced circuits)
    [DIGITAL_IO.SchDoc, FPGA_SHIELD_MARK1.PrjPcb, POWER_SUPPLY.SchDoc]
2012-04-16 Changed USB footprint slightly to ensure proper fit. Had to shrink size of LPC programming pads slightly to get plated thru holes. I think it is set for fab.
2012-05-05 Added somenotes about the LPC1343 bootup mistakes....
    [FPGA_SHIELD_MARK1.PrjPcb, LOGIC_MCU.SchDoc]
2012-05-08 Made fixes to config push button. Modified the PMOD headers.
    [DIGITAL_IO.SchDoc, FPGA_SHIELD_MARK1.PrjPcb, LOGIC_MCU.SchDoc]
2012-05-09 Added headers, wired schematic. Place parts.
    [MARK1_EDU_PMOD.PcbDoc, MARK1_EDU_PMOD.PrjPcb, MARK1_EDU_PMOD.SchDoc]
2012-05-11 Added audio, joystick.
    [MARK1_EDU_PMOD.PcbDoc, MARK1_EDU_PMOD.SchDoc]
2012-05-11 Updated EDU model
    [Assembly BOM-FPGA_SHIELD_MARK1.xls, FPGA_SHIELD_MARK1.PrjPcb, Pricing BOM-FPGA_SHIELD_MARK1.xls]
2012-05-12 Added SD card, icons to sch parts
    [MARK1_EDU_PMOD.PcbDoc, MARK1_EDU_PMOD.SchDoc]
2012-05-14 added different sd connector (push-push). Allows for bypass on topside, easier to use, debug.
    [MARK1_EDU_PMOD.PcbDoc, MARK1_EDU_PMOD.SchDoc]
2012-05-15 Config 1. potential placement for config1. could use config 2 to only use 3 pmod ports.
    [MARK1_EDU_PMOD.PcbDoc, MARK1_EDU_PMOD.SchDoc]
2012-05-17 Final placement and wiring, gettting ready to route
    [MARK1_EDU_PMOD.PcbDoc, MARK1_EDU_PMOD.PrjPcb, MARK1_EDU_PMOD.SchDoc]
2012-05-18 Beginning route
    [MARK1_EDU_PMOD.PcbDoc, MARK1_EDU_PMOD.SchDoc]
2012-05-21 almost done
    [MARK1_EDU_PMOD.PcbDoc, MARK1_EDU_PMOD.PrjPcb, MARK1_EDU_PMOD.SchDoc]
2012-05-21 Needs eli approval.
    [MARK1_EDU_PMOD.PcbDoc, MARK1_EDU_PMOD.PrjPcb, MARK1_EDU_PMOD.SchDoc]
2012-05-22 submitting for fab
    [MARK1_EDU_PMOD.PcbDoc, MARK1_EDU_PMOD.PrjPcb]
2012-06-08 Rev A for Board Quotes. Removed clock connection to FPGA from Micro. Fixed button issue for starting bootloader. Fixed some random silkscreen stuff
    [ARDUINO_IO.SchDoc, Assembly BOM-FPGA_SHIELD_MARK1.xls, DIGITAL_IO.SchDoc, FPGA_POWER_AND_CONFIGURATION.SchDoc, FPGA_SHIELD_MARK1.PrjPcb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]
2012-06-08 Cleaning up to reorganize SCH-Releases by Folder
    [FPGA_SHIELD_MARK1_Single_Side.GBL, FPGA_SHIELD_MARK1_Single_Side.GBO, FPGA_SHIELD_MARK1_Single_Side.GBP, FPGA_SHIELD_MARK1_Single_Side.GBS, FPGA_SHIELD_MARK1_Single_Side.GTL, FPGA_SHIELD_MARK1_Single_Side.GTO, FPGA_SHIELD_MARK1_Single_Side.GTP, FPGA_SHIELD_MARK1_Single_Side.GTS]
2012-06-08 Added Rev A into a folder by itself to better track future versions
    [ANALOG_IO.SchDoc, ARDUINO_IO.SchDoc, Assembly BOM - NO_THRU-HOLE-FPGA_SHIELD_MARK1(NO_THRU-HOLE).xls, Assembly BOM - PMODS-FPGA_SHIELD_MARK1(PMODS).xls, DIGITAL_IO.SchDoc, EXTERNAL_IO.SchDoc, FPGA_Logic.SchDoc, FPGA_MCU_Control_Top.SchDoc]
2012-07-10 changed seg ctrl net labels. were backward
    [MARK1_EDU_PMOD.PrjPcb]
2012-07-10 PB net labels were label in reverse order. fixed
    [DIGITAL_IO.SchDoc, FPGA_SHIELD_MARK1.PrjPcb, LOGIC_FPGA.SchDoc, PMOD_IO.SchDoc]
2012-07-10 Error marker on placement of swithc. Reversed. Needs to be flipped on PCB
    [DIGITAL_IO.SchDoc]
2012-07-10 The LED's need mirrored on PCB to show proper bit from MSB to LSB left to right. Made notes on schematic.
    [DIGITAL_IO.SchDoc, LOGIC_FPGA.SchDoc]
